hardwarewrighter/hex1000/(commit log)

2026-10-18 Import X_eTaL HEX1000 foundation for Nano 1K calculator
    Add machine, calculator and panel sources with pinned evaluator setup, 22 regression baselines, 156 doc examples, reference RTL and core simulation. Document import provenance, unverified wiring, disconnected peripherals and remaining keypad/MAX7219 integration. Gate, ROM check, Icarus simulation and Gowin core fit pass.
2026-10-18 docs: implementation notes for the Nano 1K calculator
    docs/implementation-notes.md records, for the Linux agent:
    - the user's decisions: keypad legends (C D E F / 8 9 A B / 4 5 6 7 /
    0 1 2 3, top to bottom), K1 + K2 - K3 * K4 =, the calculator rules;
    - how the pad maps onto the machine's own scan (one keypad row per
    machine column R8-R11, the strip on R12, C1-C4 as K0-K3);
    - why a front-panel module sits between the pad/display and the core
    (bounce, the common-ground strip, the MAX7219 stream) and its design:
    tri-stated row scan, synchronized pulled-up inputs, whole-scan
    debounce, the 13-word MAX7219 loop in no-decode mode with pn:Font;
    - hex1000.net corrections: a 74AHCT125 on DIN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
2026-10-18 Correct Nano 1K keypad pins and reconcile wiring documentation
    Reject QFN48 power/ground pins 25/26 and map keypad R1/R2 to 15/16. Preserve the other 13 unique peripheral assignments, add the planned 74AHCT125 display paths, and align row scanning and pull-ups with the Mac front-panel plan. Record vendor and local database evidence and pending configuration-pin checks. No hardware was programmed.
2026-10-18 Add physical Nano 1K Dupont wiring diagrams
    Map every keypad, operator and display cable to Sipeed's USB-up board photo. Move C2/C3 to header-accessible FPGA pins 20/35, include 1 kohm row resistors and a DIP14 MAX7219 level-shifter diagram, and update the netlist and docs. The generator rejects duplicate or non-header signal assignments; rendered SVGs and PNGs were visually inspected. No board was programmed.
2026-10-18 Add printable TXS0108E display wiring diagram
    Show breakout channel labels, FPGA header positions, 3.3 V and 5 V supplies, common ground and manual OE startup procedure. Keep the 74AHCT125 diagram as the original alternative. Regenerated diagrams and visually inspected the new PNG.
2026-10-19 Run peripheral-free HEX1000 self-test on Nano 1K SRAM
    Add a divided-clock wrapper that internally enters 12+34=, checks 46 and reports pass/failure through RGB LEDs, with a watchdog and heartbeat. Simulate reset, key handshakes, display capture and injected failures; guard pins and require GW1NZ-1 JTAG ID before SRAM loading. Full gate passes; synthesis and routed timing pass with 2 block RAMs. Record source/image hashes and successful physical SRAM load/CRC, with user LED observation still pending. Flash unchanged.
    [board-selftest.py, selftest.tb.v, selftest.v, test-board-selftest.py]
2026-10-19 Implement and flash physical Nano 1K HEX1000 calculator
    Add the X_eTaL Front model and reviewed new regression/type baselines, clock-matched RTL scanner/debounce/key handshake and MAX7219 stream. Translate the second consecutive equals into the existing ROM Clear key; retain all core/library semantics and wrapped overflow. Add production-timing matrix/SPI simulations, global machine clock routing, pin/device guards and reproducible SRAM/flash builds. Full gate passes 25 baselines and 178 doc examples plus model and board checks. Program the identified GW1NZ-1 internal flash with CRC success. Update TXS wiring to automatic OE on pin 23 with 10 kohm pull-down, record evidence and first wired-t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
2026-10-19 Clarify TXS0108E OE wiring for blank-display diagnosis
    Draw FPGA23-to-OE explicitly with a 10 kohm branch to ground, rather than leaving the resistor in a text footer. Explain that missing pull-down alone does not keep a properly driven OE disabled. Record the user's first blank display with green LED and leave electrical diagnosis pending. Regenerated and visually inspected the wiring diagram; no FPGA programming occurred.
    [wiring-diagram.py]
2026-10-19 Prepare isolated display diagnostic and GPIO-load checks
    Add a simulation-checked 5 kHz SPI diagnostic that sends eight zeros at minimum brightness without calculator or switch logic. Guard source/image hashes and device ID, allow SRAM only, and preserve calculator flash. Correct the optional OE label and document the 10 kohm load-only check: unloaded 3.3 V does not prove active GPIO drive. Record reported supply/OE measurements; no diagnostic has been loaded and diagnosis remains pending the isolated load reading. Simulation, synthesis, routed timing and diagram checks pass.
    [display-probe.py, display-probe.tb.v, display-probe.v, wiring-diagram.py]
2026-10-19 Record corrected OE pin and display diagnostic SRAM load
    User corrected the mistaken programmer GPIO to FPGA23, measuring OE at 3.29 V. Calculator display remained blank. Load the guarded 5 kHz eight-zero fixture into the identified GW1NZ-1 SRAM; CRC succeeds and flash remains unchanged. Record image hashes/logs and keep physical display observation explicitly pending.
2026-10-19 Show DEADBEEF until first key and verify persistent calculator programming
    Model startup display selection in X_eTaL and match RTL cycle traces. Review Front regression and type baseline updates; test banner persistence through bounce and normal first-key processing at production scan timing. Record physical DEADBEEF confirmation and the disconnected display power lead. Require explicit loader CRC success and use uncompressed packing after compressed flash checksum mismatch; program the Nano 1K flash with successful CRC.
2026-10-19 Fix Nano 1K keypad output-enable polarity and record physical arithmetic
    Diagnose inverse row selection with an independent slow raw row/column SRAM probe. Preserve S1/S5 readings, identify the installed packer TO=INV default, and explicitly select TO=SIG for all four diagnostic and calculator row buffers. Confirm corrected S1 behavior physically without changing pins or key assignments.
    Guard missing/inverted constraints and routed row attributes. Test all 16 diagnostic positions, SPI framing and a simulated row short; full gate passes 25 baselines, 184 doc examples, eight programming guards and board simulations. Program corrected persistent calculator flash with successful CRC.
    Update w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
    [board-calculator.py, keypad-probe.py, keypad-probe.tb.v, keypad-probe.v, test-board-selftest.py]
